josem1942/psx-adapter/hardware/psx-hid.kicad_pcb

## KiCad design hardware/psx-hid.kicad_pcb (2026-10-21)

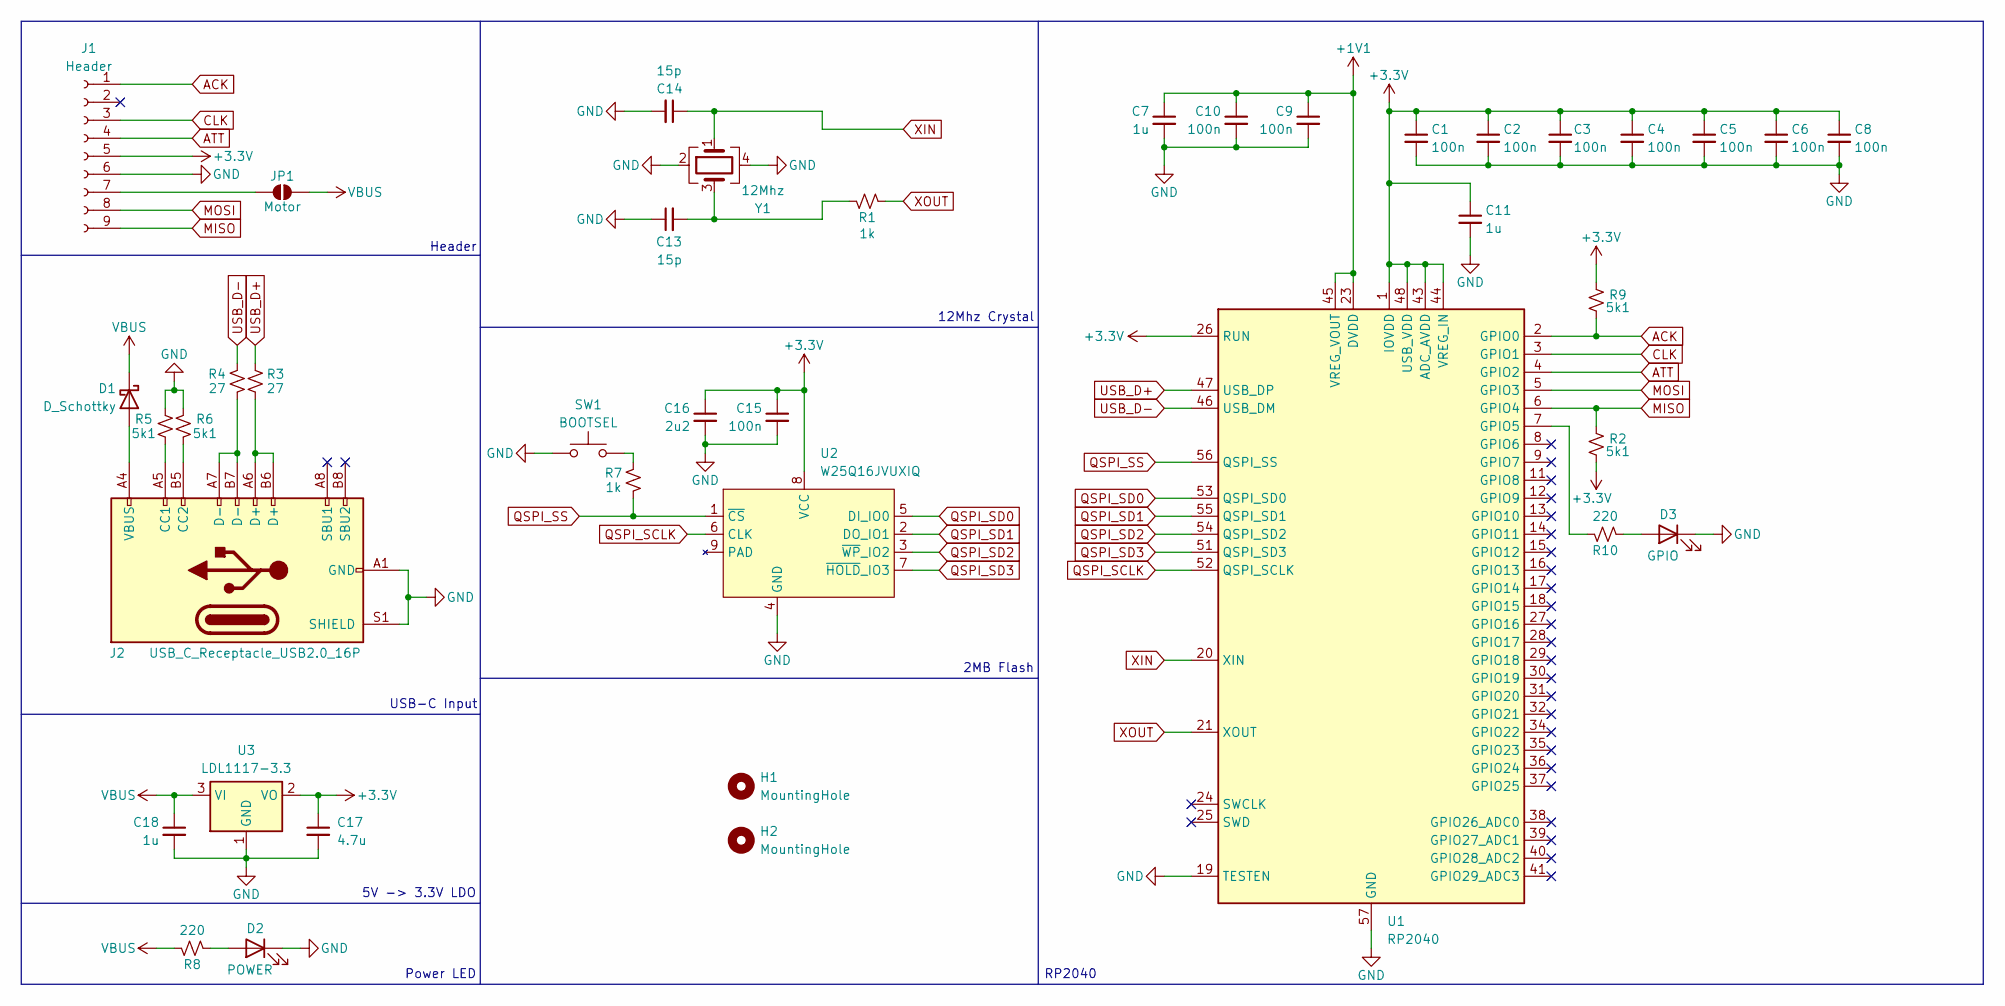
[picture p1: schematic psx-hid.kicad_sch, PSX to HID]

Parts:
C1, C2, C3, C4, C5, C6, C8, C9, C10, C15: 100n; C_0603_1608Metric; Mfr. # CC0603KRX7R9BB104; LCSC C14663
C7, C11, C18: 1u; C_0603_1608Metric; Mfr. # CL10A105KB8NNNC; LCSC C15849
C13, C14: 15p; C_0603_1608Metric; Mfr. # CL10C150JB8NNNC; LCSC C1644
C16: 2u2; C_0805_2012Metric; Mfr. # CL21A225KBQNNNE; LCSC C377773
C17: 4.7u; C_0603_1608Metric; Mfr. # CL10A475KO8NNNC; LCSC C19666
D1: D_Schottky; D_SOD-123F; Mfr. # B5819W SL; LCSC C8598
D2: POWER; LED_0805_2012Metric; Mfr. # NCD0805R1; LCSC C84256
D3: GPIO; LED_0805_2012Metric; Mfr. # NCD0805R1; LCSC C84256
H1, H2: MountingHole; MountingHole_3.2mm_M3
J1: Header; PSX_Interface
J2: USB_C_Receptacle_USB2.0_16P; USB_C_Receptacle_GCT_USB4105-xx-A_16P_TopMnt_Horizontal; Mfr. # USB4105-GF-A-060; LCSC C3025063
JP1: Motor; SolderJumper-2_P1.3mm_Open_Pad1.0x1.5mm
R1, R7: 1k; R_0603_1608Metric; Mfr. # 0603WAF1001T5E; LCSC C21190
R2, R5, R6, R9: 5k1; R_0402_1005Metric; Mfr. # 0402WGF5101TCE; LCSC C25905
R3, R4: 27; R_0402_1005Metric; Mfr. # 0402WGF270JTCE; LCSC C25100
R8, R10: 220; R_0402_1005Metric; Mfr. # 0402WGF2200TCE; LCSC C25091
SW1: BOOTSEL; SW_Push_1P1T_NO_CK_KMR2; Mfr. # KMR211GLFS; LCSC C221675
U1: RP2040; QFN-56-1EP_7x7mm_P0.4mm_EP3.2x3.2mm; Mfr. # RP2040; LCSC C2040
U2: W25Q16JVUXIQ; Winbond_USON-8-1EP_3x2mm_P0.5mm_EP0.2x1.6mm; Mfr. # GD25Q16EEIGR; LCSC C2986331
U3: LDL1117-3.3; SOT-223-3_TabPin2; Mfr. # LDL1117S33R; LCSC C435835
Y1: 12Mhz; Crystal_SMD_Abracon_ABM8G-4Pin_3.2x2.5mm; Mfr. # ABM8-272-T3; LCSC C20625731

Connections:
+1V1: C7.1, C9.1, C10.1, U1.23 (DVDD), U1.45 (VREG_VOUT), U1.50 (DVDD)
+3.3V: C1.1, C2.1, C3.1, C4.1, C5.1, C6.1, C8.1, C11.1, C15.1, C16.1, C17.1, J1.5, R2.2, R9.1, U1.1 (IOVDD), U1.10 (IOVDD), U1.22 (IOVDD), U1.26 (RUN), U1.33 (IOVDD), U1.42 (IOVDD), U1.43 (ADC_AVDD), U1.44 (VREG_IN), U1.48 (USB_VDD), U1.49 (IOVDD), U2.8 (VCC), U3.2 (VO)
ACK: J1.1, R9.2, U1.2 (GPIO0)
ATT: J1.4, U1.4 (GPIO2)
CLK: J1.3, U1.3 (GPIO1)
GND: C1.2, C2.2, C3.2, C4.2, C5.2, C6.2, C7.2, C8.2, C9.2, C10.2, C11.2, C13.1, C14.2, C15.2, C16.2, C17.2, C18.2, D2.1 (K), D3.1 (K), J1.6, J2.A1 (GND), J2.A12 (GND), J2.B1 (GND), J2.B12 (GND), J2.S1 (SHIELD), R5.2, R6.2, SW1.1, U1.19 (TESTEN), U1.57 (GND), U2.4 (GND), U3.1 (GND), Y1.2, Y1.4
MISO: J1.9, R2.1, U1.6 (GPIO4)
MOSI: J1.8, U1.5 (GPIO3)
unnamed: C13.2, R1.1, Y1.3
unnamed: D1.2 (A), J2.A4 (VBUS), J2.A9 (VBUS), J2.B4 (VBUS), J2.B9 (VBUS)
unnamed: D2.2 (A), R8.2
unnamed: D3.2 (A), R10.2
unnamed: J1.7, JP1.1 (A)
unnamed: J2.A5 (CC1), R5.1
unnamed: J2.B5 (CC2), R6.1
unnamed: J2.A6 (D+), J2.B6 (D+), R3.2
unnamed: J2.A7 (D-), J2.B7 (D-), R4.2
unnamed: R7.1, SW1.2
unnamed: R10.1, U1.7 (GPIO5)
QSPI_SCLK: U1.52 (QSPI_SCLK), U2.6 (CLK)
QSPI_SD0: U1.53 (QSPI_SD0), U2.5 (DI_IO0)
QSPI_SD1: U1.55 (QSPI_SD1), U2.2 (DO_IO1)
QSPI_SD2: U1.54 (QSPI_SD2), U2.3 (~WP_IO2)
QSPI_SD3: U1.51 (QSPI_SD3), U2.7 (~HOLD_IO3)
QSPI_SS: R7.2, U1.56 (QSPI_SS), U2.1 (~CS)
USB_D+: R3.1, U1.47 (USB_DP)
USB_D-: R4.1, U1.46 (USB_DM)
VBUS: C18.1, D1.1 (K), JP1.2 (B), R8.1, U3.3 (VI)
XIN: C14.1, U1.20 (XIN), Y1.1
XOUT: R1.2, U1.21 (XOUT)

Notes on the sheet:
Header
5V -> 3.3V LDO
2MB Flash
12Mhz Crystal
USB-C Input
Power LED
RP2040

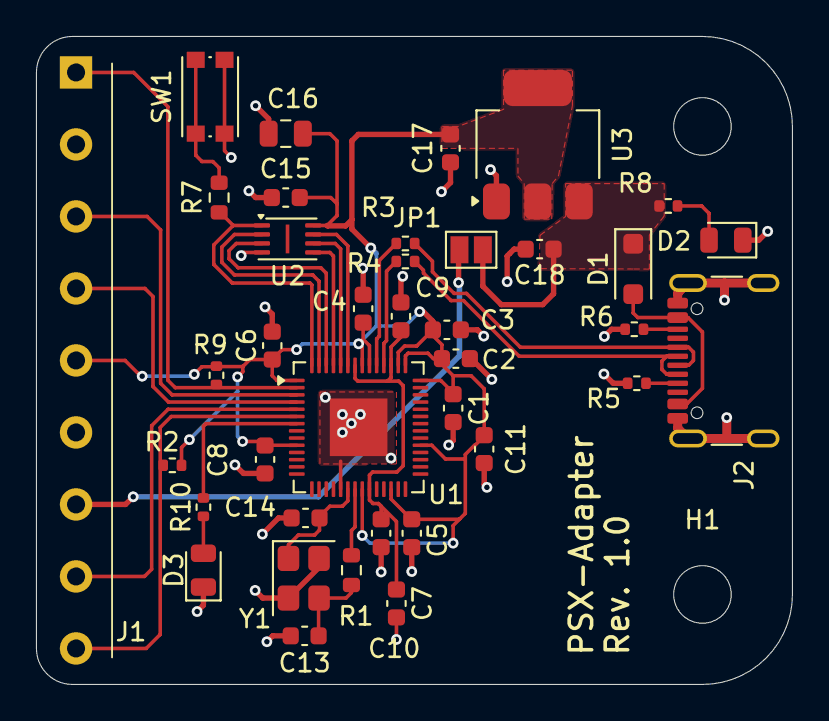
[picture p2: board psx-hid.kicad_pcb from above]

Board: 2 copper layers, 42.0 x 36.0 mm, 40 parts (0 on the bottom side), 30 nets.
